martinhofherr/EPROMShield/eprom_overview.png

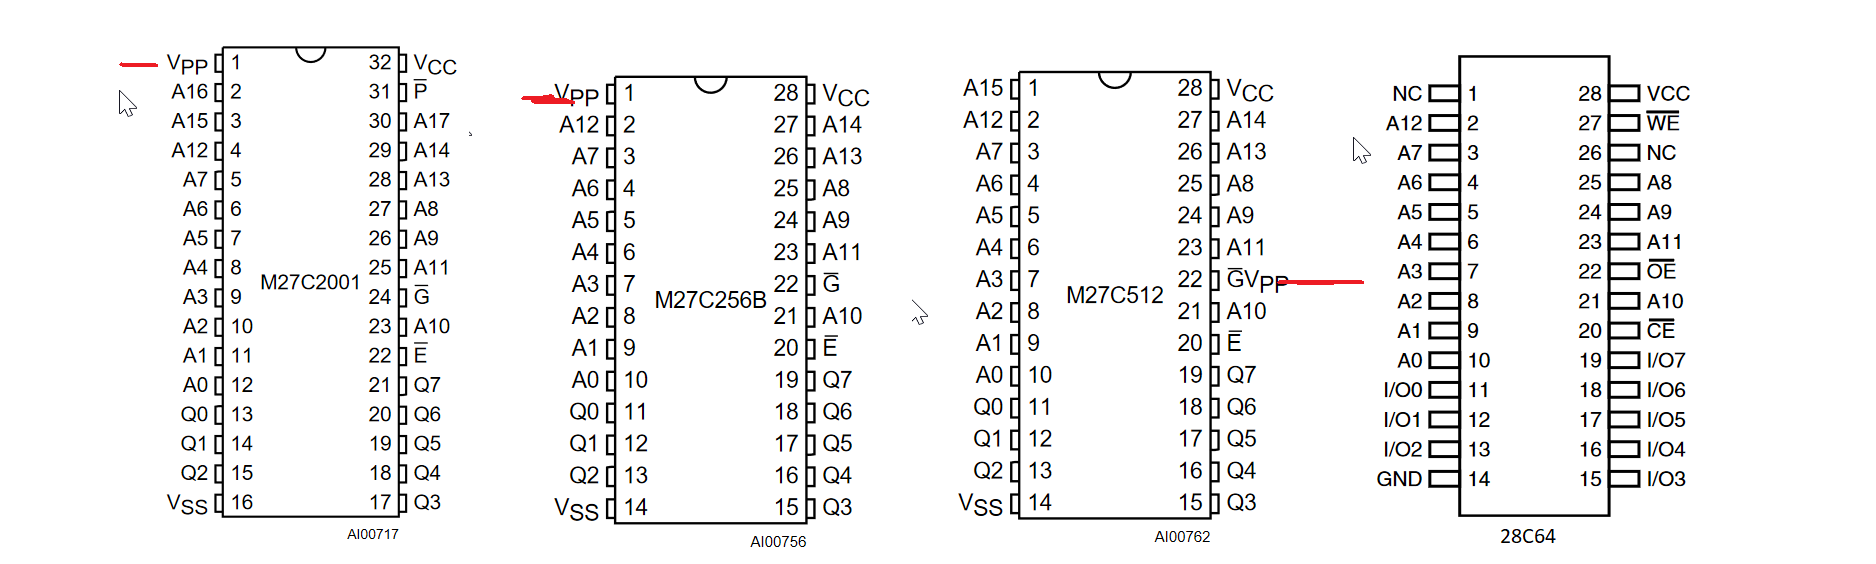
eprom_overview.png
