martinhofherr/EPROMShield/simulation/PGM_Supply.asc

D1: diode; 1N4148
M1: pmos; BSS84
M2: nmos; BSB012N03LX3
Q1: npn; BC847B
R1: res; 1k
R2: res; 10k
R3: res; 10k
R4: res; 1k5
R5: res; 10k
V1: voltage; 12
V2: voltage; 5
V3: voltage; PULSE(0 5 100m 1n 1n 100m 200m 2)
V4: voltage; 0
Named nets: 0, 12V, 5V, Vout
.tran 500m
