martinhofherr/EPROMShield/EPROMShield/EPROMShield.kicad_pcb

## KiCad design EPROMShield/EPROMShield.kicad_pcb (2021-08-24)

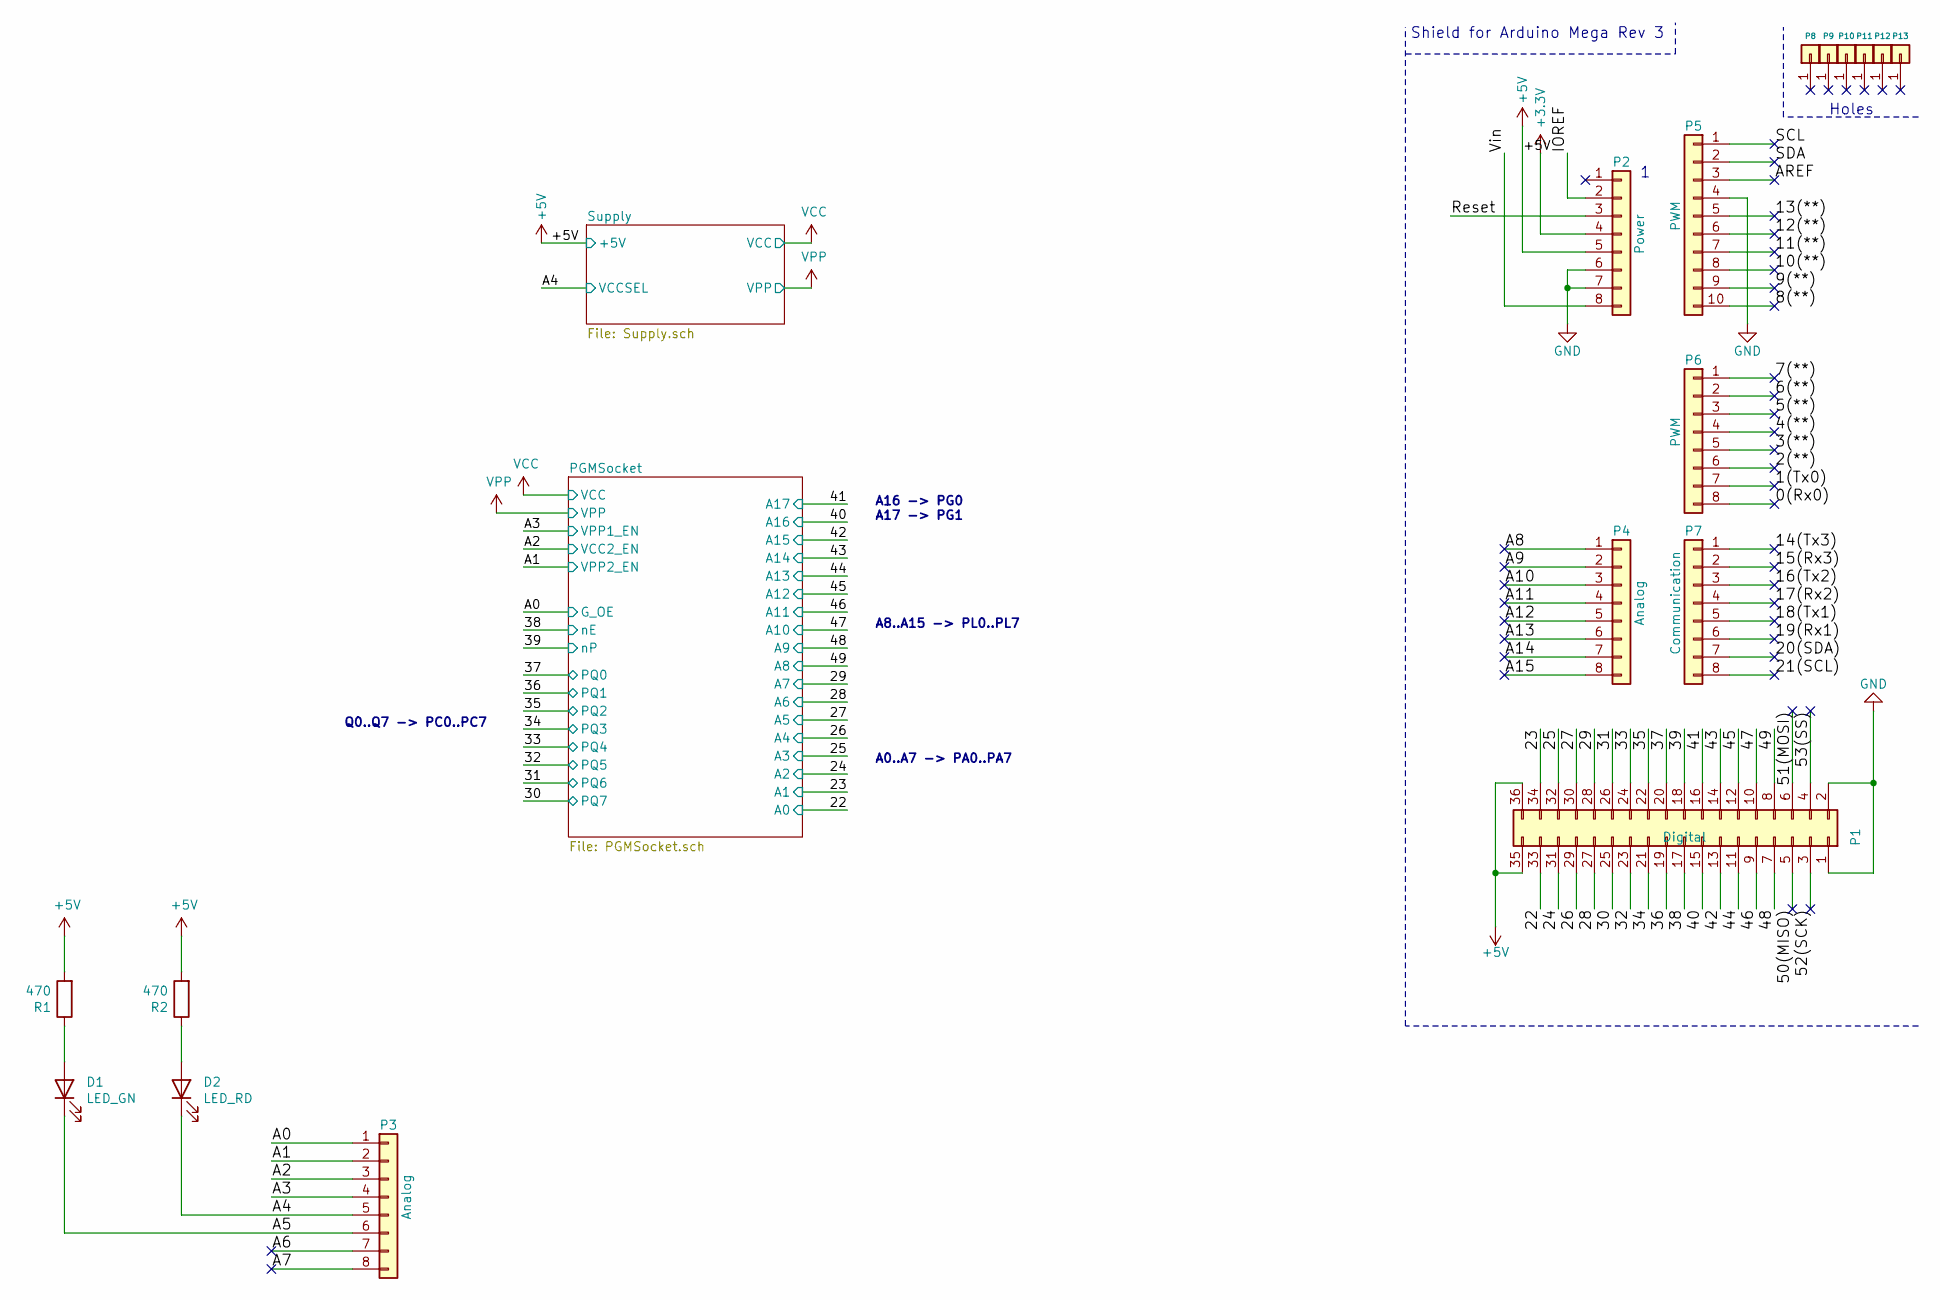
[picture p2: schematic EPROMShield.sch, Arduino Connections]

Parts:
D1: LED_GN; LED_1206_3216Metric_Pad1.42x1.75mm_HandSolder
D2: LED_RD; LED_1206_3216Metric_Pad1.42x1.75mm_HandSolder
P1: Digital; Socket_Strip_Arduino_2x18
P2: Power; Socket_Strip_Arduino_1x08
P3, P4: Analog; Socket_Strip_Arduino_1x08
P5: PWM; Socket_Strip_Arduino_1x10
P6: PWM; Socket_Strip_Arduino_1x08
P7: Communication; Socket_Strip_Arduino_1x08
P8, P9, P10, P11, P12, P13: CONN_01X01; Arduino_1pin
R1, R2: 470; R_0805_2012Metric_Pad1.20x1.40mm_HandSolder

Connections:
+3V3: P2.4
+5V: P1.35, P1.36, P2.5, R1.2, R2.2; also elsewhere on the board
/0(Rx0): P6.8
/1(Tx0): P6.7
/2(**): P6.6
/3(**): P6.5
/4(**): P6.4
/5(**): P6.3
/6(**): P6.2
/7(**): P6.1
/8(**): P5.10
/9(**): P5.9
/10(**): P5.8
/11(**): P5.7
/12(**): P5.6
/13(**): P5.5
/14(Tx3): P7.1
/15(Rx3): P7.2
/16(Tx2): P7.3
/17(Rx2): P7.4
/18(Tx1): P7.5
/19(Rx1): P7.6
/20(SDA): P7.7
/21(SCL): P7.8
/22: P1.33; also elsewhere on the board
/23: P1.34; also elsewhere on the board
/24: P1.31; also elsewhere on the board
/25: P1.32; also elsewhere on the board
/26: P1.29; also elsewhere on the board
/27: P1.30; also elsewhere on the board
/28: P1.27; also elsewhere on the board
/29: P1.28; also elsewhere on the board
/30: P1.25; also elsewhere on the board
/31: P1.26; also elsewhere on the board
/32: P1.23; also elsewhere on the board
/33: P1.24; also elsewhere on the board
/34: P1.21; also elsewhere on the board
/35: P1.22; also elsewhere on the board
/36: P1.19; also elsewhere on the board
/37: P1.20; also elsewhere on the board
/38: P1.17; also elsewhere on the board
/39: P1.18; also elsewhere on the board
/40: P1.15; also elsewhere on the board
/41: P1.16; also elsewhere on the board
/42: P1.13; also elsewhere on the board
/43: P1.14; also elsewhere on the board
/44: P1.11; also elsewhere on the board
/45: P1.12; also elsewhere on the board
/46: P1.9; also elsewhere on the board
/47: P1.10; also elsewhere on the board
/48: P1.7; also elsewhere on the board
/49: P1.8; also elsewhere on the board
/50(MISO): P1.5
/51(MOSI): P1.6
/52(SCK): P1.3
/53(SS): P1.4
/A0: P3.1; also elsewhere on the board
/A1: P3.2; also elsewhere on the board
/A2: P3.3; also elsewhere on the board
/A3: P3.4; also elsewhere on the board
/A4: D2.1 (K), P3.5; also elsewhere on the board
/A5: D1.1 (K), P3.6
/A6: P3.7
/A7: P3.8
/A8: P4.1
/A9: P4.2
/A10: P4.3
/A11: P4.4
/A12: P4.5
/A13: P4.6
/A14: P4.7
/A15: P4.8
/AREF: P5.3
/IOREF: P2.2
/Reset: P2.3
/SCL: P5.1
/SDA: P5.2
/Vin: P2.8
GND: P1.1, P1.2, P2.6, P2.7, P5.4; also elsewhere on the board
unnamed: D1.2 (A), R1.1
unnamed: D2.2 (A), R2.1

Notes on the sheet:
Shield for Arduino Mega Rev 3
Holes
Q0..Q7 -> PC0..PC7
A0..A7 -> PA0..PA7
A8..A15 -> PL0..PL7
A16 -> PG0 A17 -> PG1

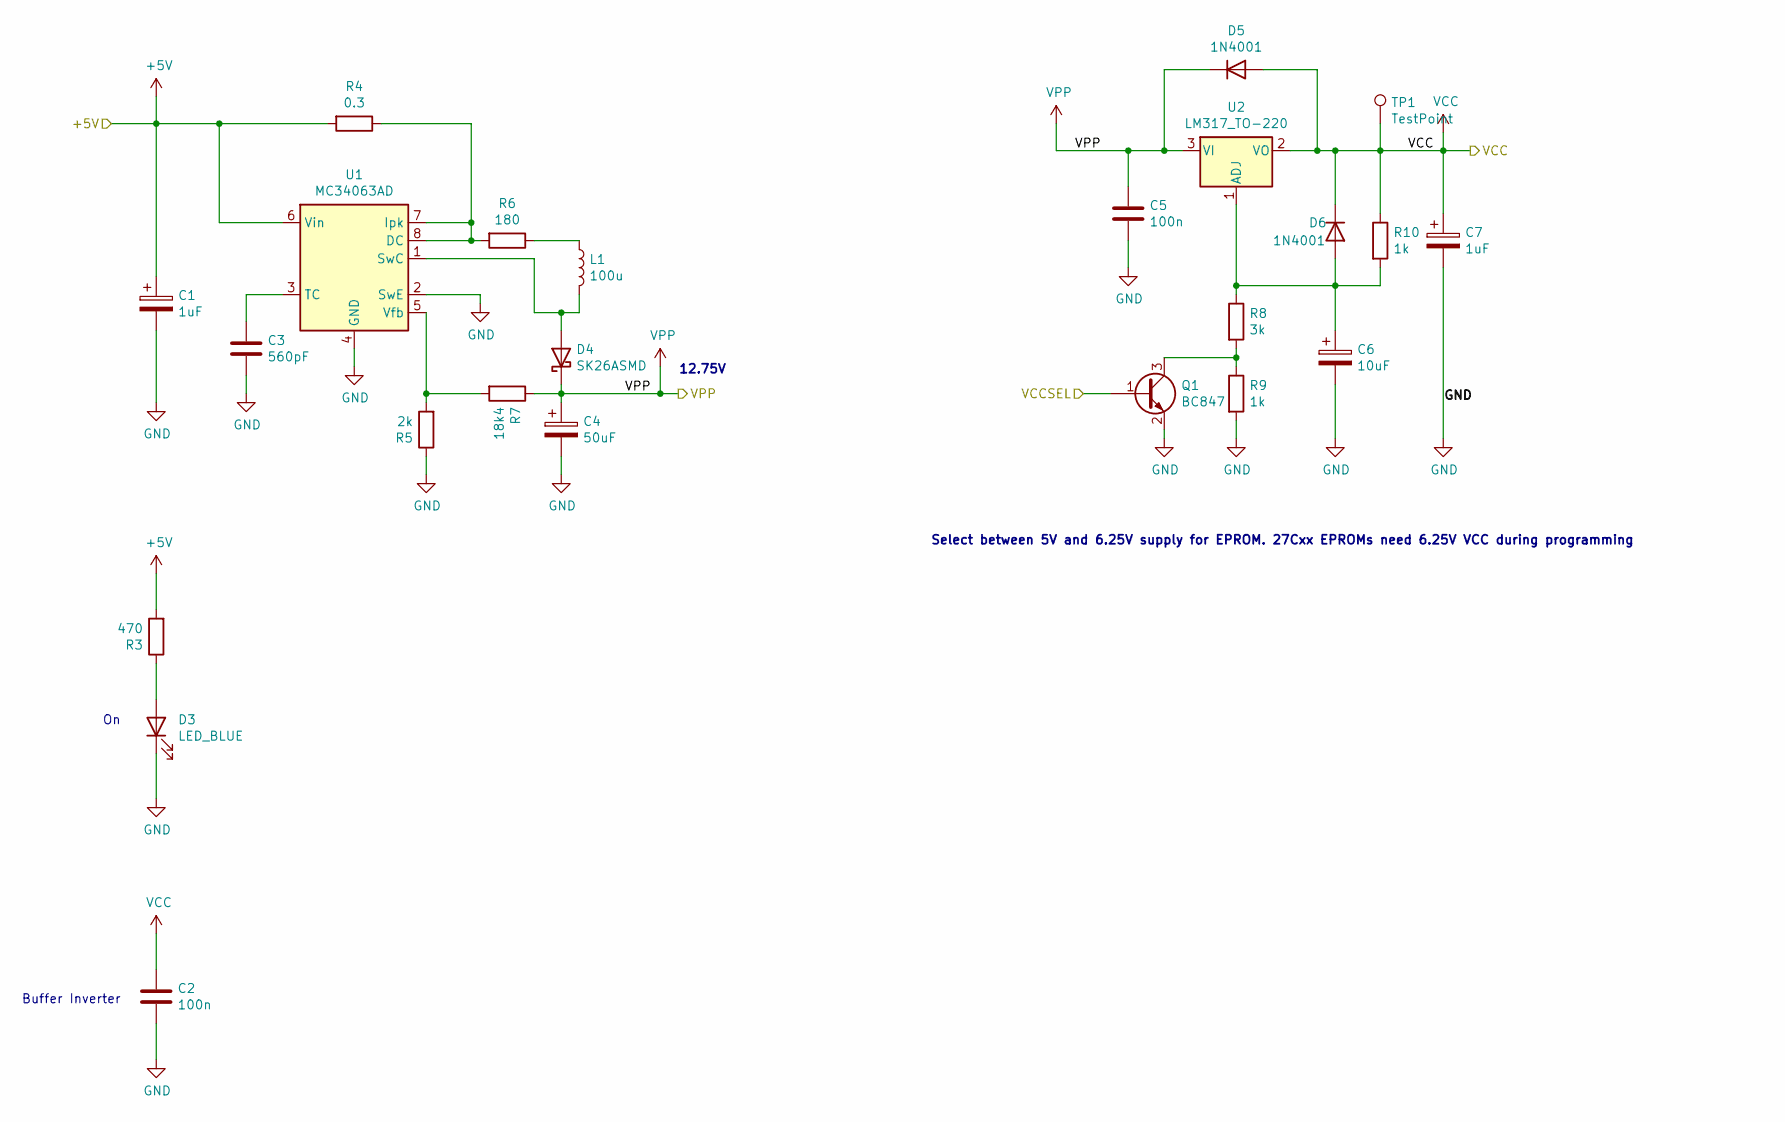
[picture p3: schematic Supply.sch]

Parts:
C1: 1uF; CP_Radial_D4.0mm_P1.50mm
C2, C5: 100n; C_0805_2012Metric_Pad1.18x1.45mm_HandSolder
C3: 560pF; C_0805_2012Metric_Pad1.18x1.45mm_HandSolder
C4: 50uF; CP_Radial_D6.3mm_P2.50mm
C6: 10uF; CP_Radial_D6.3mm_P2.50mm
C7: 1uF; CP_Radial_D5.0mm_P2.50mm
D3: LED_BLUE; LED_1206_3216Metric_Pad1.42x1.75mm_HandSolder
D4: SK26ASMD; D_SMA_Handsoldering
D5, D6: 1N4001; D_MELF
L1: 100u; L_Fastron_PISN_Handsoldering
Q1: BC847; SOT-23
R3: 470; R_0805_2012Metric_Pad1.20x1.40mm_HandSolder
R4: 0.3; R_1206_3216Metric_Pad1.30x1.75mm_HandSolder
R5: 2k; R_0805_2012Metric_Pad1.20x1.40mm_HandSolder
R6: 180; R_0805_2012Metric_Pad1.20x1.40mm_HandSolder
R7: 18k4; R_0805_2012Metric_Pad1.20x1.40mm_HandSolder
R8: 3k; R_0805_2012Metric_Pad1.20x1.40mm_HandSolder
R9, R10: 1k; R_0805_2012Metric_Pad1.20x1.40mm_HandSolder
TP1: TestPoint; TestPoint_Pad_D2.0mm
U1: MC34063AD; SOIC-8_3.9x4.9mm_P1.27mm
U2: LM317_TO-220; TO-220F-3_Horizontal_TabDown

Connections:
+5V: C1.1, R3.2, R4.2, U1.6 (Vin); also elsewhere on the board
/A4: Q1.1 (B); also elsewhere on the board
GND: C1.2, C2.2, C3.2, C4.2, C5.2, C6.2, C7.2, D3.1 (K), Q1.2 (E), R5.1, R9.2, U1.2 (SwE), U1.4 (GND); also elsewhere on the board
unnamed: C3.1, U1.3 (TC)
unnamed: C6.1, D6.2 (A), R8.1, R10.2, U2.1 (ADJ)
unnamed: D3.2 (A), R3.1
unnamed: D4.2 (A), L1.2, U1.1 (SwC)
unnamed: L1.1, R6.1
unnamed: Q1.3 (C), R8.2, R9.1
unnamed: R4.1, R6.2, U1.7 (Ipk), U1.8 (DC)
unnamed: R5.2, R7.2, U1.5 (Vfb)
VCC: C2.1, C7.1, D5.2 (A), D6.1 (K), R10.1, TP1.1, U2.2 (VO); also elsewhere on the board
VPP: C4.1, C5.1, D4.1 (K), D5.1 (K), R7.1, U2.3 (VI); also elsewhere on the board

Notes on the sheet:
Buffer Inverter
Select between 5V and 6.25V supply for EPROM. 27Cxx EPROMs need 6.25V VCC during programming
12.75V

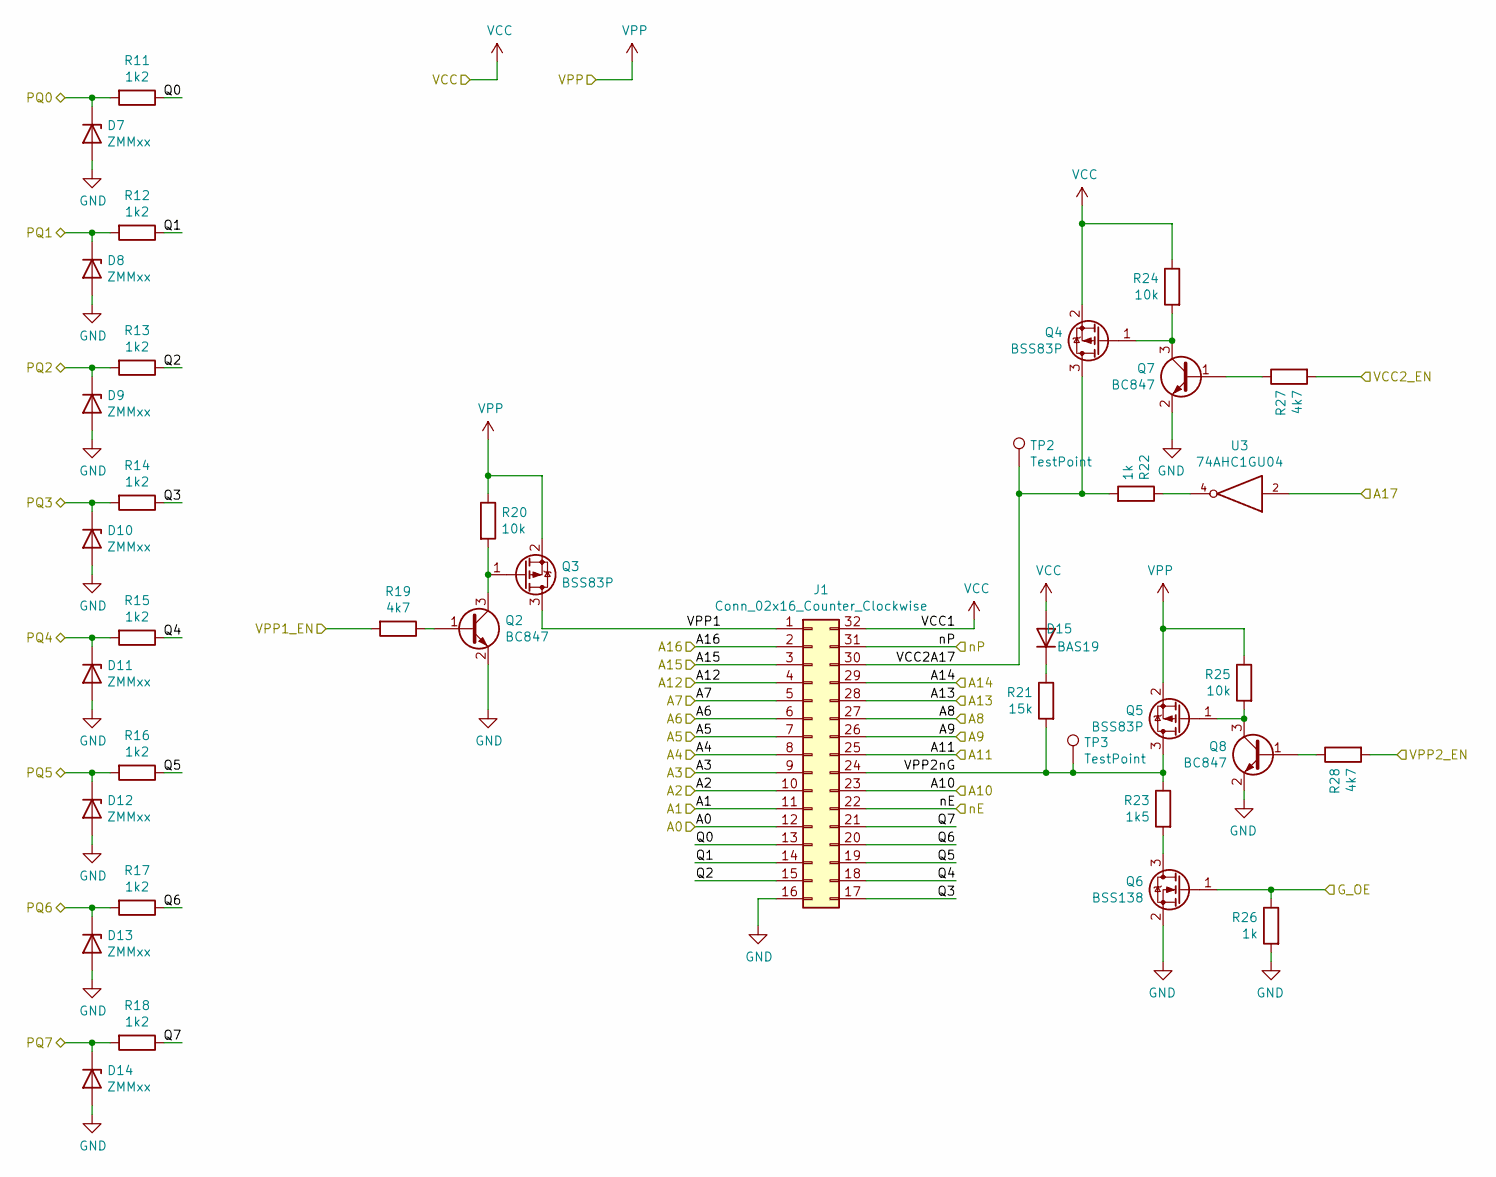
[picture p4: schematic PGMSocket.sch, Programming Socket]

Parts:
D7, D8, D9, D10, D11, D12, D13, D14: ZMMxx; D_MiniMELF
D15: BAS19; SOT-23
J1: Conn_02x16_Counter_Clockwise; DIP_Socket-32_W11.9_W12.7_W15.24_W17.78_W18.5_3M_232-1285-0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
Q2, Q7, Q8: BC847; SOT-23
Q3, Q4, Q5: BSS83P; SOT-23
Q6: BSS138; SOT-23
R11, R12, R13, R14, R15, R16, R17, R18: 1k2; R_0805_2012Metric_Pad1.20x1.40mm_HandSolder
R19, R27, R28: 4k7; R_0805_2012Metric_Pad1.20x1.40mm_HandSolder
R20, R24, R25: 10k; R_0805_2012Metric_Pad1.20x1.40mm_HandSolder
R21: 15k; R_0805_2012Metric_Pad1.20x1.40mm_HandSolder
R22, R26: 1k; R_0805_2012Metric_Pad1.20x1.40mm_HandSolder
R23: 1k5; R_0805_2012Metric_Pad1.20x1.40mm_HandSolder
TP2, TP3: TestPoint; TestPoint_Pad_D2.0mm
U3: 74AHC1GU04; SOT-353_SC-70-5_Handsoldering

Connections:
/22: J1.12; also elsewhere on the board
/23: J1.11; also elsewhere on the board
/24: J1.10; also elsewhere on the board
/25: J1.9; also elsewhere on the board
/26: J1.8; also elsewhere on the board
/27: J1.7; also elsewhere on the board
/28: J1.6; also elsewhere on the board
/29: J1.5; also elsewhere on the board
/30: D14.1 (K), R18.2; also elsewhere on the board
/31: D13.1 (K), R17.2; also elsewhere on the board
/32: D12.1 (K), R16.2; also elsewhere on the board
/33: D11.1 (K), R15.2; also elsewhere on the board
/34: D10.1 (K), R14.2; also elsewhere on the board
/35: D9.1 (K), R13.2; also elsewhere on the board
/36: D8.1 (K), R12.2; also elsewhere on the board
/37: D7.1 (K), R11.2; also elsewhere on the board
/38: J1.22; also elsewhere on the board
/39: J1.31; also elsewhere on the board
/40: J1.2; also elsewhere on the board
/41: U3.2; also elsewhere on the board
/42: J1.3; also elsewhere on the board
/43: J1.29; also elsewhere on the board
/44: J1.28; also elsewhere on the board
/45: J1.4; also elsewhere on the board
/46: J1.25; also elsewhere on the board
/47: J1.23; also elsewhere on the board
/48: J1.26; also elsewhere on the board
/49: J1.27; also elsewhere on the board
/A0: Q6.1 (G), R26.1; also elsewhere on the board
/A1: R28.2; also elsewhere on the board
/A2: R27.2; also elsewhere on the board
/A3: R19.2; also elsewhere on the board
/PGMSocket/Q0: J1.13, R11.1
/PGMSocket/Q1: J1.14, R12.1
/PGMSocket/Q2: J1.15, R13.1
/PGMSocket/Q3: J1.17, R14.1
/PGMSocket/Q4: J1.18, R15.1
/PGMSocket/Q5: J1.19, R16.1
/PGMSocket/Q6: J1.20, R17.1
/PGMSocket/Q7: J1.21, R18.1
/PGMSocket/VCC2A17: J1.30, Q4.3 (D), R22.2, TP2.1
/PGMSocket/VPP1: J1.1, Q3.3 (D)
/PGMSocket/VPP2nG: J1.24, Q5.3 (D), R21.2, R23.1, TP3.1
GND: D7.2 (A), D8.2 (A), D9.2 (A), D10.2 (A), D11.2 (A), D12.2 (A), D13.2 (A), D14.2 (A), J1.16, Q2.2 (E), Q6.2 (S), Q7.2 (E), Q8.2 (E), R26.2, U3.3 (GND); also elsewhere on the board
unnamed: D15.3 (K), R21.1
unnamed: Q2.1 (B), R19.1
unnamed: Q2.3 (C), Q3.1 (G), R20.2
unnamed: Q4.1 (G), Q7.3 (C), R24.2
unnamed: Q5.1 (G), Q8.3 (C), R25.2
unnamed: Q6.3 (D), R23.2
unnamed: Q7.1 (B), R27.1
unnamed: Q8.1 (B), R28.1
unnamed: R22.1, U3.4
VCC: D15.1 (A), J1.32, Q4.2 (S), R24.1, U3.5 (VCC); also elsewhere on the board
VPP: Q3.2 (S), Q5.2 (S), R20.1, R25.1; also elsewhere on the board

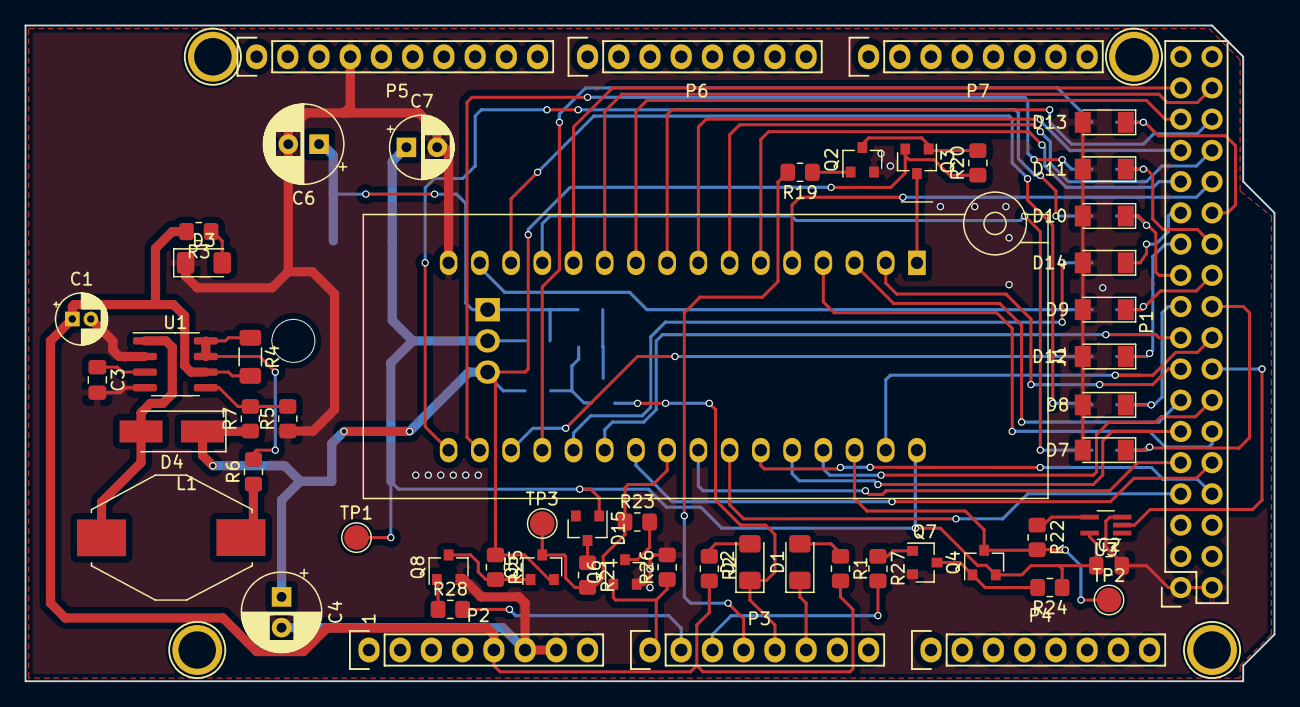
[picture p5: board EPROMShield.kicad_pcb from above]

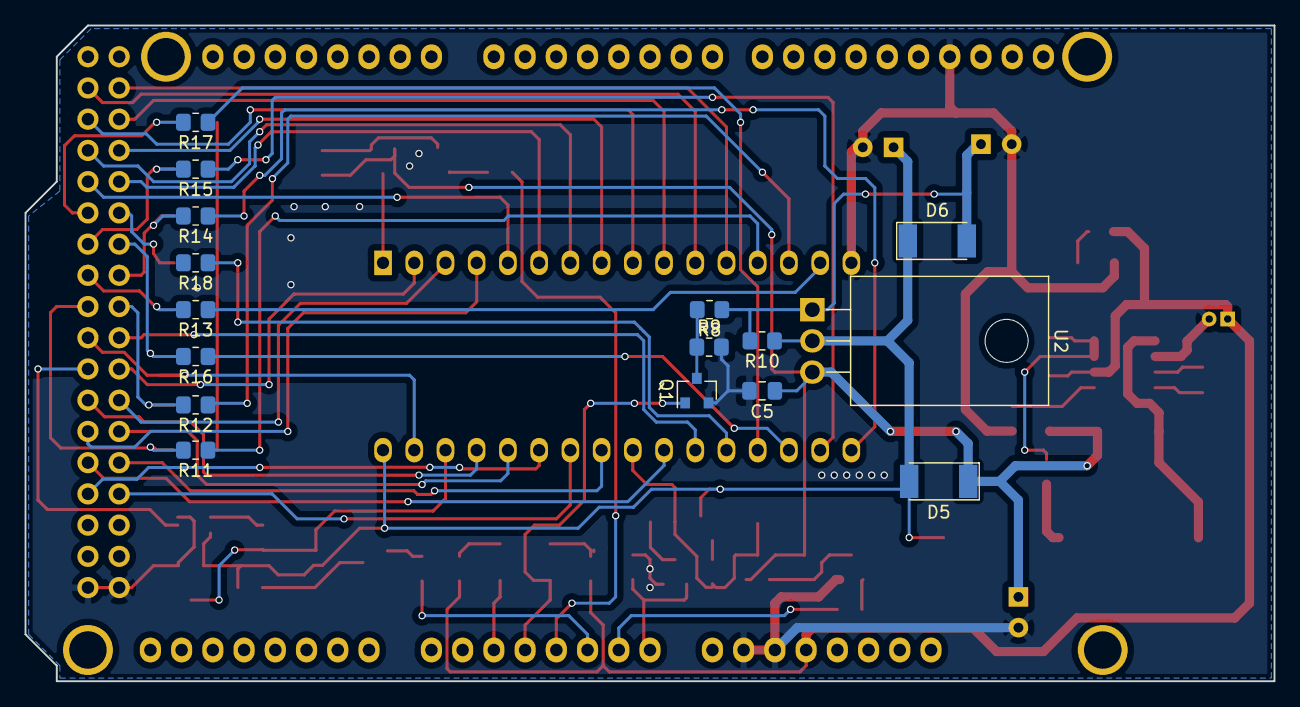
[picture p6: board EPROMShield.kicad_pcb from below]

Board: 2 copper layers, 101.6 x 53.3 mm, 77 parts (16 on the bottom side), 68 nets.
