martinhofherr/EPROMShield/design_calculations/mc34063_step_up.png

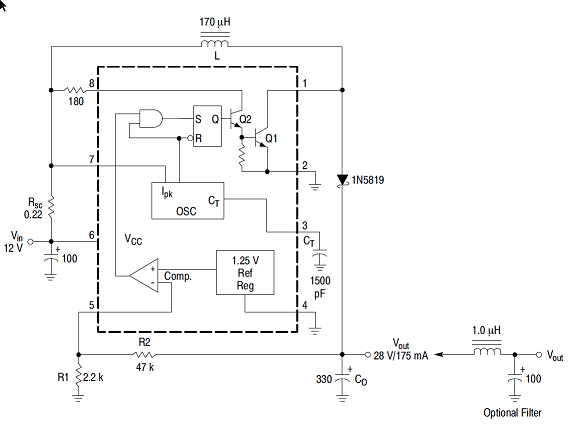
design_calculations/mc34063_step_up.png
