martinhofherr/EPROMShield/design_calculations/step_up_formula.png

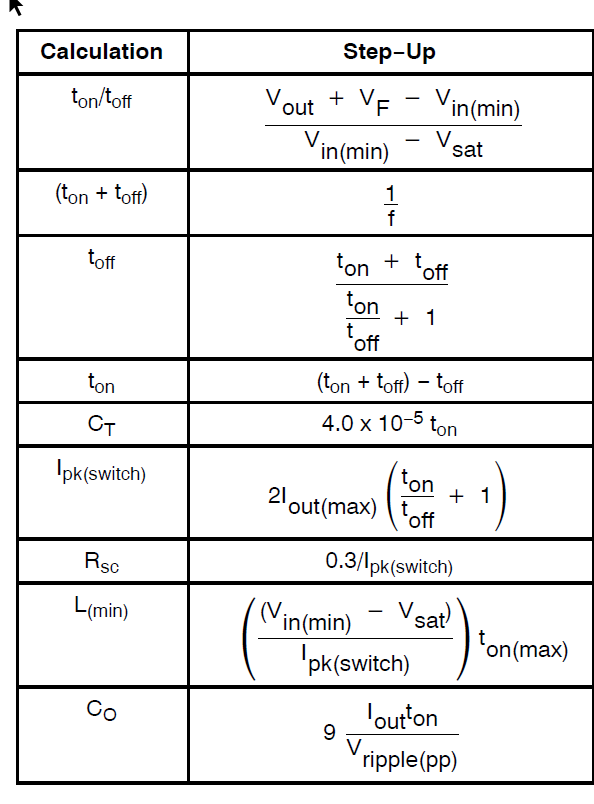
design_calculations/step_up_formula.png
