martinhofherr/EPROMShield/(commit log)

2021-08-22 Finished schematic added caluclation for boost converter
    [EPROMShield.sch, IOProtection.sch, PGMSocket.sch, Supply.sch]
2021-08-22 Footprints associated
    [EPROMShield.sch, PGMSocket.sch, Supply.sch]
2021-08-22 Added netlist, fixed footprint L1
    [EPROMShield.kicad_pcb, Supply.sch]
2021-08-22 First shot at component placement. Fixed VCC connection for Inverter
    [EPROMShield.kicad_pcb, PGMSocket.sch, Supply.sch]
2021-08-24 First Version routing is done
    [EPROMShield.kicad_pcb, EPROMShield.sch, PGMSocket.sch, Supply.sch]
2021-08-24 Routing update
    [EPROMShield.kicad_pcb]
